lukewarner127/BlueBox-2/BB2.0_Schematic.png

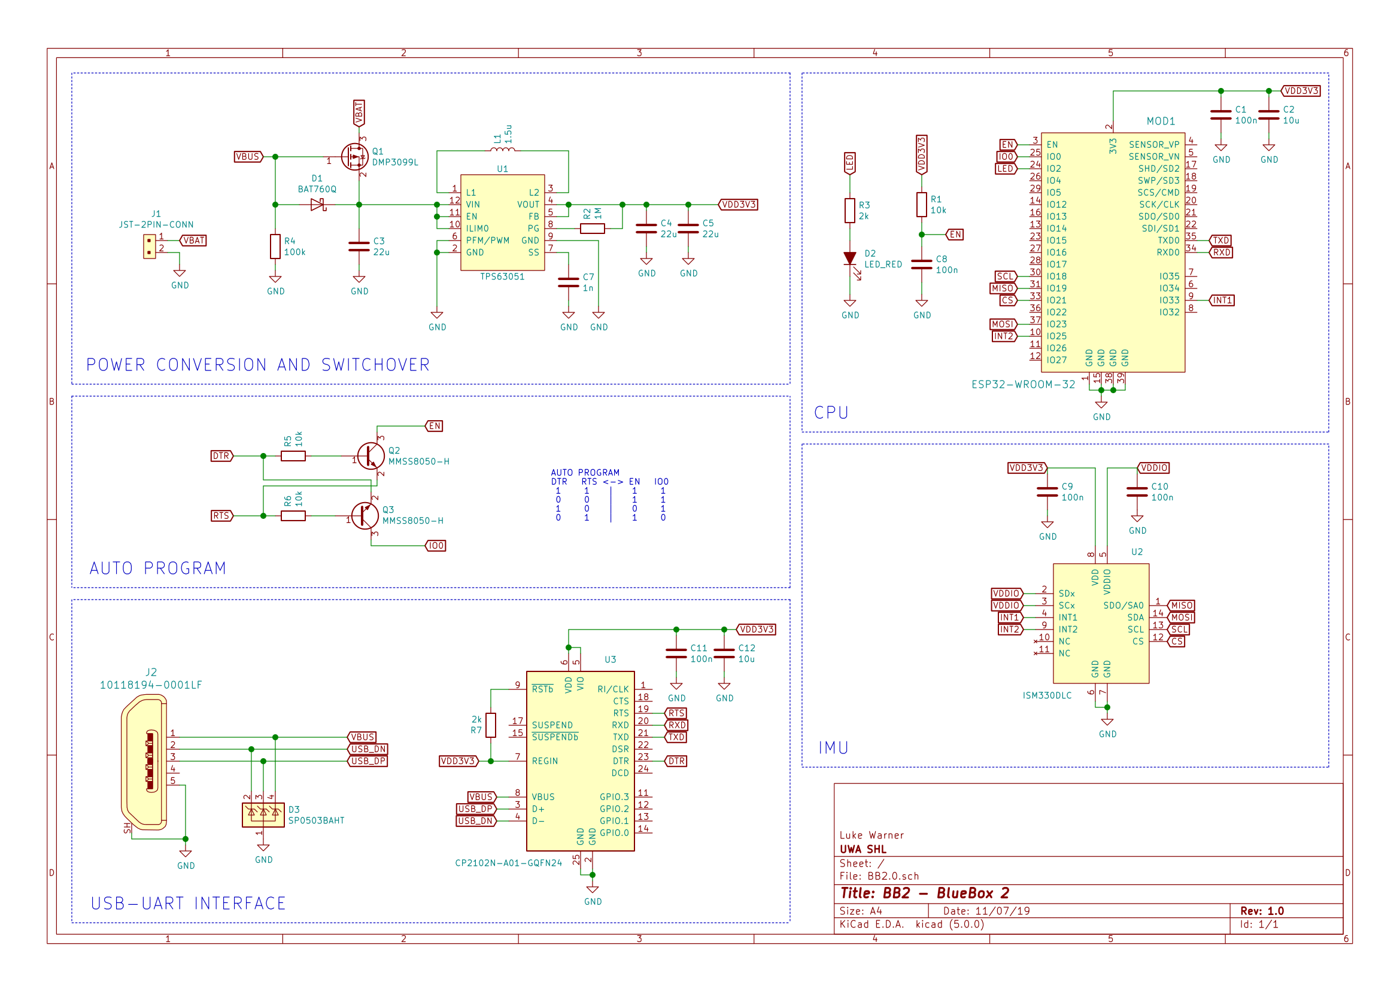
BB2.0_Schematic.png
