lukewarner127/BlueBox-2/BB2_BOM.xlsx

Sheet: Sheet1
Name | Description | Package/Size | Source | Qty | Price | Cost | Link
ESP32 | RF Transciever Module | (25.5x18.0 mm) | Digi-Key | 1 | 7.38 | 7.38 | https://www.digikey.com.au/product-detail/en/espressif-systems/ESP32-WROOM-32-16MB/1904-1020-1-ND/9381729
 | 10k Resistor | 0603 | Digi-Key | 1 | 0.15 | 0.15 | https://www.digikey.com.au/product-detail/en/rohm-semiconductor/ESR03EZPJ103/RHM10KDCT-ND/1762925
 | 10u Capacitor | 0603 | Digi-Key | 1 | 0.22 | 0.22 | https://www.digikey.com.au/product-detail/en/samsung-electro-mechanics/CL10A106MQ8NNNC/1276-1119-1-ND/3889205
 | 100n Capacitor | 0603 | Digi-Key | 2 | 0.15 | 0.30 | https://www.digikey.com.au/product-detail/en/samsung-electro-mechanics/CL10B104KB8NNNC/1276-1000-1-ND/3889086
 | Red LED | 0603 | Digi-Key | 1 | 0.22 | 0.22 | https://www.digikey.com.au/product-detail/en/wurth-electronics-inc/150060RS75000/732-4978-1-ND/4489899
 | 2k Resistor | 0603 | Digi-Key | 1 | 0.15 | 0.15 | https://www.digikey.com.au/product-detail/en/rohm-semiconductor/ESR03EZPJ202/RHM2.0KDCT-ND/1762928
ISM330DLC | IMU | LGA-14L (2.5x3.0 mm) | Digi-Key | 1 | 5.94 | 5.94 | https://www.digikey.com.au/product-detail/en/stmicroelectronics/ISM330DLCTR/497-17583-1-ND/7565507
 | 100n Capacitor | 0603 | Digi-Key | 2 | 0.15 | 0.30 | https://www.digikey.com.au/product-detail/en/samsung-electro-mechanics/CL10B104KB8NNNC/1276-1000-1-ND/3889086
CP2102N | USB to UART Bridge | 24-QFN (4.0x4.0 mm) | Digi-Key | 1 | 2.10 | 2.10 | https://www.digikey.com.au/product-detail/en/silicon-labs/CP2102N-A02-GQFN24R/336-5888-1-ND/9863482
 | 10u Capacitor | 0603 | Digi-Key | 1 | 0.15 | 0.15 | https://www.digikey.com.au/product-detail/en/samsung-electro-mechanics/CL10A106MQ8NNNC/1276-1119-1-ND/3889205
 | 100n Capacitor | 0603 | Digi-Key | 1 | 0.15 | 0.15 | https://www.digikey.com.au/product-detail/en/samsung-electro-mechanics/CL10B104KB8NNNC/1276-1000-1-ND/3889086
 | 2k Resistor | 0603 | Digi-Key | 1 | 0.15 | 0.15 | https://www.digikey.com.au/product-detail/en/rohm-semiconductor/ESR03EZPJ202/RHM2.0KDCT-ND/1762928
10118194-0001LF | Micro USB-B Connector |  | Digi-Key | 1 | 0.63 | 0.63 | https://www.digikey.com.au/product-detail/en/amphenol-icc-fci/10118194-0001LF/609-4618-1-ND/2785382
SP0503BAHT | TVS Diode Array | SOT-143-4 | Digi-Key | 1 | 1.32 | 1.32 | https://www.digikey.com.au/product-detail/en/littelfuse-inc/SP0503BAHTG/F2715CT-ND/1154322
TPS63051 | Buck-Boost Converter | VQFN (12) 2.5x2.5 mm | Digi-Key | 1 | 2.82 | 2.82 | https://www.digikey.com.au/product-detail/en/texas-instruments/TPS63051RMWR/296-42650-1-ND/5455915
1239AS-H-1R5M | 1.5u Inductor | 1008 | Digi-Key | 1 | 0.63 | 0.63 | https://www.digikey.com.au/product-detail/en/murata-electronics-north-america/1239AS-H-1R5M=P2/490-10565-1-ND/5272023
 | 22u Capacitor | 0805 | Digi-Key | 3 | 0.27 | 0.81 | https://www.digikey.com.au/product-detail/en/samsung-electro-mechanics/CL21A226MQQNNNE/1276-1100-1-ND/3889186
 | 1n Capacitor | 0603 | Digi-Key | 1 | 0.15 | 0.15 | https://www.digikey.com.au/product-detail/en/samsung-electro-mechanics/CL10C102JB8NNNC/1276-1091-1-ND/3889177
 | 1M Resistor | 0603 | Digi-Key | 1 | 0.15 | 0.15 | https://www.digikey.com.au/product-detail/en/rohm-semiconductor/ESR03EZPJ105/RHM1MDCT-ND/4053711
JST 2-Pin Connector | Battery connector |  | Digi-Key | 1 | 0.25 | 0.25 | https://www.digikey.com.au/product-detail/en/jst-sales-america-inc/S2B-PH-K-S-LF-SN/455-1719-ND/926626
BAT760Q | Schottky Diode | SOD-323 | Digi-Key | 1 | 0.63 | 0.63 | https://www.digikey.com.au/product-detail/en/diodes-incorporated/BAT760Q-7/BAT760Q-7DICT-ND/8545855
DMP3099L | P-Channel Mosfet | SOT-23 | Digi-Key | 1 | 0.49 | 0.49 | https://www.digikey.com.au/product-detail/en/diodes-incorporated/DMP3099L-7/DMP3099L-7DICT-ND/5218217
 | 100k Resistor | 0603 | Digi-Key | 1 | 0.15 | 0.15 | https://www.digikey.com.au/product-detail/en/rohm-semiconductor/ESR03EZPJ104/RHM100KDCT-ND/4053710
 | 10k Resistor | 0603 | Digi-Key | 2 | 0.15 | 0.30 | https://www.digikey.com.au/product-detail/en/rohm-semiconductor/ESR03EZPJ103/RHM10KDCT-ND/1762925
SS8050 | NPN Transistor | SOT-23 | Digi-Key | 2 | 0.31 | 0.62 | https://www.digikey.com.au/product-detail/en/micro-commercial-co/MMSS8050-H-TP/MMSS8050-H-TPMSCT-ND/2825945
LiPo Battery | 400 mAh Pouch Cell | 38x25x6 mm | Core Electronics | 1 | 10.95 | 10.95 | https://core-electronics.com.au/polymer-lithium-ion-battery-400mah-38456.html
 |  |  |  |  |  | 0.00
 |  |  |  |  |  | 0.00
 |  |  |  |  |  | 0.00
 |  |  |  |  |  | 0.00
 |  |  |  |  |  | 37.11

Sheet: Sheet2
 | Name | Description | Package/Size | Source | Qty | Price | Cost | Link | Order Qty
1 | ESP32 | RF Transciever Module | (25.5x18.0 mm) | Digi-Key | 1 | 7.38 | 7.38 | https://www.digikey.com.au/product-detail/en/espressif-systems/ESP32-WROOM-32-16MB/1904-1020-1-ND/9381729 | 0 | 0.00
2 | 1239AS-H-1R5M | 1.5u Inductor | 1008 | Digi-Key | 1 | 0.63 | 0.63 | https://www.digikey.com.au/product-detail/en/murata-electronics-north-america/1239AS-H-1R5M=P2/490-10565-1-ND/5272023 | 6 | 3.78
3 |  | 100k Resistor | 0603 | Digi-Key | 1 | 0.15 | 0.15 | https://www.digikey.com.au/product-detail/en/rohm-semiconductor/ESR03EZPJ104/RHM100KDCT-ND/4053710 | 6 | 0.90
4 |  | 100n Capacitor | 0603 | Digi-Key | 5 | 0.04 | 0.21 | https://www.digikey.com.au/product-detail/en/samsung-electro-mechanics/CL10B104KB8NNNC/1276-1000-1-ND/3889086 | 30 | 1.26
5 |  | 10k Resistor | 0603 | Digi-Key | 3 | 0.12 | 0.37 | https://www.digikey.com.au/product-detail/en/rohm-semiconductor/ESR03EZPJ103/RHM10KDCT-ND/1762925 | 18 | 2.23
6 |  | 10u Capacitor | 0603 | Digi-Key | 2 | 0.17 | 0.33 | https://www.digikey.com.au/product-detail/en/samsung-electro-mechanics/CL10A106MQ8NNNC/1276-1119-1-ND/3889205 | 12 | 1.98
7 |  | 1M Resistor | 0603 | Digi-Key | 1 | 0.15 | 0.15 | https://www.digikey.com.au/product-detail/en/rohm-semiconductor/ESR03EZPJ105/RHM1MDCT-ND/4053711 | 6 | 0.90
8 |  | 1n Capacitor | 0603 | Digi-Key | 1 | 0.07 | 0.07 | https://www.digikey.com.au/product-detail/en/samsung-electro-mechanics/CL10C102JB8NNNC/1276-1091-1-ND/3889177 | 10 | 0.70
9 |  | 22u Capacitor | 0805 | Digi-Key | 3 | 0.18 | 0.54 | https://www.digikey.com.au/product-detail/en/samsung-electro-mechanics/CL21A226MQQNNNE/1276-1100-1-ND/3889186 | 18 | 3.26
10 |  | 2k Resistor | 0603 | Digi-Key | 2 | 0.12 | 0.25 | https://www.digikey.com.au/product-detail/en/rohm-semiconductor/ESR03EZPJ202/RHM2.0KDCT-ND/1762928 | 12 | 1.49
11 | Li-Ion Battery | 400 mAh Pouch Cell | 38x25x6 mm | Core Electronics | 1 | 10.95 | 10.95 | https://core-electronics.com.au/polymer-lithium-ion-battery-400mah-38456.html | 0 | 0.00
12 | JST 2-Pin Connector | Battery connector |  | Digi-Key | 1 | 0.25 | 0.25 | https://www.digikey.com.au/product-detail/en/jst-sales-america-inc/S2B-PH-K-S-LF-SN/455-1719-ND/926626 | 6 | 1.50
13 | TPS63051 | Buck-Boost Converter | VQFN (12) 2.5x2.5 mm | Digi-Key | 1 | 2.80 | 2.80 | https://www.digikey.com.au/product-detail/en/texas-instruments/TPS63051RMWR/296-42650-1-ND/5455915 | 4 | 11.20
14 | ISM330DLC | IMU | LGA-14L (2.5x3.0 mm) | Digi-Key | 1 | 5.94 | 5.94 | https://www.digikey.com.au/product-detail/en/stmicroelectronics/ISM330DLCTR/497-17583-1-ND/7565507 | 0 | 0.00
15 | SS8050 | NPN Transistor | SOT-23 | Digi-Key | 2 | 0.28 | 0.57 | https://www.digikey.com.au/product-detail/en/micro-commercial-co/MMSS8050-H-TP/MMSS8050-H-TPMSCT-ND/2825945 | 12 | 3.42
16 | DMP3099L | P-Channel Mosfet | SOT-23 | Digi-Key | 1 | 0.49 | 0.49 | https://www.digikey.com.au/product-detail/en/diodes-incorporated/DMP3099L-7/DMP3099L-7DICT-ND/5218217 | 6 | 2.94
17 |  | Red LED | 0603 | Digi-Key | 1 | 0.22 | 0.22 | https://www.digikey.com.au/product-detail/en/wurth-electronics-inc/150060RS75000/732-4978-1-ND/4489899 | 6 | 1.32
18 | BAT760Q | Schottky Diode | SOD-323 | Digi-Key | 1 | 0.63 | 0.63 | https://www.digikey.com.au/product-detail/en/diodes-incorporated/BAT760Q-7/BAT760Q-7DICT-ND/8545855 | 6 | 3.78
19 | SP0503BAHT | TVS Diode Array | SOT-143-4 | Digi-Key | 1 | 1.32 | 1.32 | https://www.digikey.com.au/product-detail/en/littelfuse-inc/SP0503BAHTG/F2715CT-ND/1154322 | 6 | 7.92
20 | Micro USB-B Receptacle | USB Connector |  | Digi-Key | 1 | 0.63 | 0.63 | https://www.digikey.com.au/product-detail/en/amphenol-icc-fci/10118194-0001LF/609-4618-1-ND/2785382 | 6 | 3.78
21 | CP2102N | USB to UART Bridge | 24-QFN (4.0x4.0 mm) | Digi-Key | 1 | 2.02 | 2.02 | https://www.digikey.com.au/product-detail/en/silicon-labs/CP2102N-A02-GQFN24R/336-5888-1-ND/9863482 | 4 | 8.08
22 | LiPo Charger |  |  |  |  | 13.00 | 0.00 |  | 1 | 13.00
23 | PCB |  |  |  | 1 | 1.00 | 1.00 |  |  | 0.00
24 | 3D printed case | $40 per kg | 25g |  | 0.025 | 40.00 | 1.00 |  |  | 0.00
 |  |  |  |  |  | Total | 37.90 |  | Total | 73.438
 |  | https://www.digikey.com.au/short/p9hzhf
 |  | Passive Components |  |  | 5.93
 |  | Misc |  |  | 2.88
 |  | ESP32 |  |  | 7.38
 |  | ISM330 |  |  | 5.94
 |  | LiPO Batery |  |  | 10.95
 |  | BB converter |  |  | 2.80
 |  | USB to UART bridge |  |  | 2.02
 |  |  |  |  | 37.90

Sheet: Sheet3
 |  | BlueBox 2
ID | Qty | Reference | Side | Value | Package | Name | Description
1 | 5 | C1, C8, C9, C10, C11 | F | 100nF/50V (10%) | 0603 | Capacitor | Ceramic Capacitor
2 | 2 | C2, C12 | F | 10uF/6.3V (20%) | 0603 | Capacitor | Ceramic Capacitor
3 | 3 | C3, C4, C5 | F | 22uF/6.3V (20%) | 0805 | Capacitor | Ceramic Capacitor
4 | 1 | C7 | F | 1nF/50V (5%) | 0603 | Capacitor | Ceramic Capacitor
5 | 1 | D1 | F | BAT760Q-7 | SOD-323 | BAT760Q | Schottky Diode
6 | 1 | D2 | F | 150060RS75000 | 0603 | LED | Red LED
7 | 1 | D3 | F | SP0503BAHTG | SOT-143-4 | SP0503BAHT | TVS Diode Array
8 | 1 | J1 | B | S2B-PH-KL | 1x2 Pin 2mm | 2 Pin Male Header | Conn Header R/A 2pos 2mm
9 | 1 | J2 | F | 10118194-0001LF | Micro USB-B | USB Receptacle | USB Connector
10 | 1 | L1 | F | 1.5u/2.6A (20%) | 1008 | Inductor | 1239AS-H-1R5M
11 | 1 | MOD1 | F | ESP32-WROOM-32D | (25.5x18.0x3.1 mm) | ESP32-WROOM-32D | RF Transciever Module
12 | 1 | Q1 | F | DMP3099L-7 | SOT-23 | DMP3099L | P-Channel Mosfet
13 | 2 | Q2, Q3 | F | MMSS8050-H-TP | SOT-23 | SS8050 | NPN Transistor
14 | 3 | R1, R5, R6 | F | 10k (5%) | 0603 | Resistor | Chip Resistor
15 | 1 | R2 | F | 1M (5%) | 0603 | Resistor | Chip Resistor
16 | 2 | R3, R7 | F | 2k (5%) | 0603 | Resistor | Chip Resistor
17 | 1 | R4 | F | 100k (5%) | 0603 | Resistor | Chip Resistor
18 | 1 | U1 | F | TPS63051RMWR | VQFN (12) 2.5x2.5 mm | TPS63051 | Buck-Boost Converter
19 | 1 | U2 | F | ISM330DLC | LGA-14L (2.5x3.0 mm) | ISM330 | IMU
20 | 1 | U3 | F | CP2102N-A02-GQFN24R | 24-QFN (4.0x4.0 mm) | CP2102N | USB to UART Bridge
