lukewarner127/BlueBox-2/KiCad-Files/BB2.1/BB2.1.kicad_pcb

## KiCad design KiCad-Files/BB2.1/BB2.1.kicad_pcb (2019-10-19)

Schematic: BB2.1.sch, BB2 - BlueBox 2

Parts:
C1, C8, C9, C10, C11: 100n; 0603
C2, C12: 10u; 0603
C3, C4, C5: 22u; 0805
C7: 1n; 0603
D1: BAT760Q; D_SOD-323_HandSoldering
D2: LED_RED; LED_0603
D3: SP0503BAHT; SOT-143-4_SP0503BAHT
J1: JST-2PIN-CONN; JST-2-PIN-PH-CONN; MPN S2B-PH-K-S(LF)(SN); Digi-Key_PN 455-1719-ND
J2: 10118194-0001LF; USB_Micro_B_Female_10118194-0001LF; MPN 10118194-0001LF; Digi-Key_PN 609-4618-1-ND
L1: 1.5u; Murata_Inductor
MOD1: ESP32-WROOM-32; ESP32-WROOM-32D; MPN ESP32-WROOM-32; Digi-Key_PN 1904-1010-1-ND
Q1: DMP3099L; SOT-23-3
Q2, Q3: MMSS8050-H; SOT-23-3
R1, R5, R6: 10k; 0603
R2: 1M; 0603
R3, R7: 2k; 0603
R4: 100k; 0603
U1: TPS63051; VQFN-12_2.5x2.5mm
U2: ISM330DLC; LGA-14L_2.5x3mm__LSM6DS3
U3: CP2102N-A01-GQFN24; QFN-24-1EP_4x4mm_CP2102N

Connections:
CS: MOD1.33, U2.12
DTR: Q3.2, R5.1, U3.23
EN: C8.1, MOD1.3, Q2.3, R1.2
GND: C1.2, C2.2, C3.2, C4.2, C5.2, C7.2, C8.2, C9.2, C10.2, C11.2, C12.2, D2.1, D3.1, J1.2, J2.5, J2.SH, MOD1.1, MOD1.15, MOD1.38, MOD1.39, R4.2, U1.2, U1.6, U1.9, U2.6, U2.7, U3.2, U3.25
INT1: MOD1.9, U2.4
INT2: MOD1.10, U2.9
IO0: MOD1.25, Q3.3
LED: MOD1.24, R3.1
MISO: MOD1.31, U2.1
MOSI: MOD1.37, U2.14
unnamed: C3.1, D1.1, Q1.2 (S), U1.10, U1.11, U1.12
unnamed: C7.1, U1.7
unnamed: D2.2, R3.2
unnamed: L1.1, U1.1
unnamed: L1.2, U1.3
unnamed: Q2.1, R5.2
unnamed: Q3.1, R6.2
unnamed: R2.1, U1.8
unnamed: R7.2, U3.9
RTS: Q2.2, R6.1, U3.19
RXD: MOD1.34, U3.20
SCL: MOD1.30, U2.13
TXD: MOD1.35, U3.21
USB_DN: D3.2, J2.2, U3.4
USB_DP: D3.3, J2.3, U3.3
VBAT: J1.1, Q1.3 (D)
VBUS: D1.2, D3.4, J2.1, Q1.1 (G), R4.1, U3.8
VDD3V3: C1.1, C2.1, C4.1, C5.1, C9.1, C11.1, C12.1, MOD1.2, R1.1, R2.2, R7.1, U1.4, U1.5, U2.8, U3.5, U3.6, U3.7
VDDIO: C10.1, U2.2, U2.3, U2.5

Notes on the sheet:
AUTO PROGRAM DTR RTS <-> EN IO0 1 1 | 1 1 0 0 | 1 1 1 0 | 0 1 0 1 | 1 0
CPU
IMU
USB-UART INTERFACE
AUTO PROGRAM
POWER CONVERSION AND SWITCHOVER

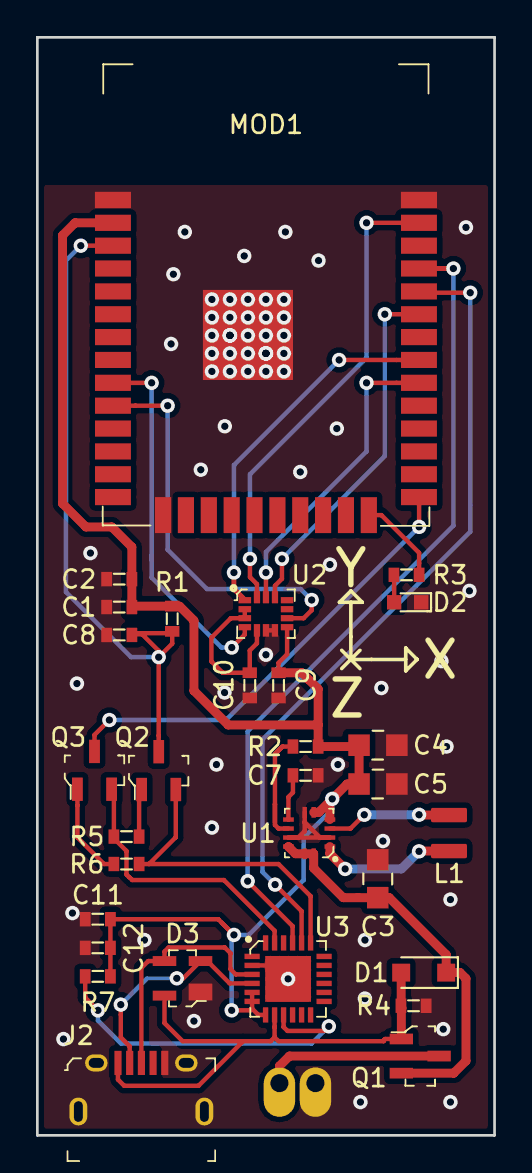
[picture p2: board BB2.1.kicad_pcb from above]

Board: 2 copper layers, 25.4 x 61.0 mm, 31 parts (1 on the bottom side), 29 nets.
